eSpark-Backup/stephen-auto-p-w-rswitcher/Design-Files/Power-Switcher-v1.0/Deliverables/_Renderings/2D_TOP_View.png

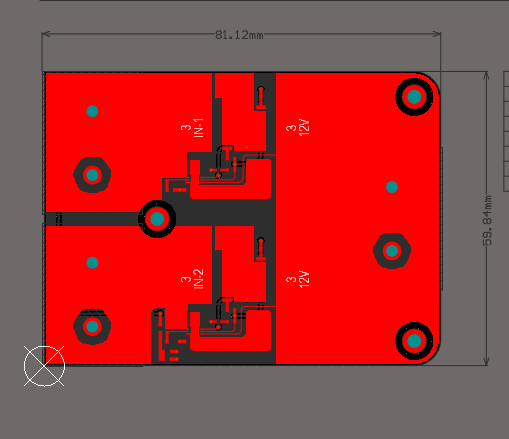
Design-Files/Power-Switcher-v1.0/Deliverables/_Renderings/2D_TOP_View.png
