eSpark-Backup/stephen-auto-p-w-rswitcher/Design-Files/Power-Switcher-v1.0/Deliverables/_Renderings/3D_Bottom_View.png

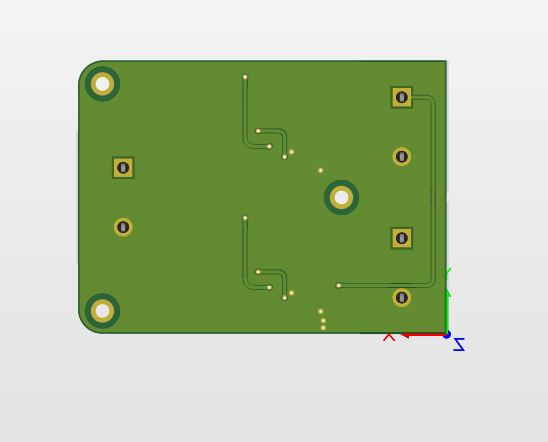
Design-Files/Power-Switcher-v1.0/Deliverables/_Renderings/3D_Bottom_View.png
