eSpark-Backup/stephen-auto-p-w-rswitcher/Design-Files/Power-Switcher-v1.0/Deliverables/BOM/Power-Switcher-v1.0.xlsx

# | Item Type | Designator | Description | Footprint | Manufacturer Part Number | Manufacturer | Value | Quantity | Remarks
1 | Capacitors | C1, C3 | CAP CER 10000PF 100V X7R 0402 | Cap-0402 | CC0402KRX7R0BB103 | Yageo | 10nF | 2
2 | Capacitor | C2, C4 | CAP CER 0.047UF 100V X7R 1206 | Cap-1206 | CC1206JRX7R0BB473 | Yageo | 0.047uF | 2
3 | Diodes | D1, D4 | DIODE ZENER 12V 200MW SOD323 | SOD-323 | MMSZ5242BS-7-F | Diodes | - | 2
4 | TVS Diodes | D2, D5 | TVS DIODE 24VWM 38.9VC DO214AC | SMA Bi Directional | SMAJ24CA | Littelfuse | - | 2
5 | Diodes | D3, D6 | DIODE STANDARD 100V 1A SMA | SMA(DO-214AC) | S1B-13-F | Diodes | - | 2
6 | Terminal Block | J1, J2, J3 | 1x2P Midfoot Barrier Block 2 1 13mm 40A -40℃~+105℃ 750V Black 10~18 Straight pin 6 Plugin,P=13mm Barrier Terminal Blocks ROHS | KF78C-13.0-2P | KF78C-13.0-2P | CiXi KaiFeng Electronics | - | 3
7 | MOSFET | Q1, Q2, Q3, Q5 | MOSFET N-CH 100V 49A/380A TOLLA | Tolla | AOTL66912 | Alpha & Omega Semiconductor | - | 4
8 | BJTs | Q4 | TRANS NPN 80V 0.5A SOT23-3 | SOT-23 | MMBTA06-7-F | Diodes | - | 1
9 | Resistor | R2, R11 | RES SMD 10 OHM 1% 1/10W 0603 | Res-0603 | RC0603FR-0710RL | Yageo | 10R | 2
10 | Resistor | R3, R5, R8, R9, R12 | RES SMD 10K Ohm 1% 1/10W 0603 | Res-0603 | RC0603FR-0710KL | Yageo | 10K | 5
11 | Resistor | R4, R6, R13 | RES SMD 1K OHM 1% 1/10W 0603 | Res-0603 | RC0603FR-071KL | Yageo | 1K | 3
12 | Resistors | R10 | RES 100K OHM 1% 1/10W 0603 | Res-0603 | RC0603FR-07100KL | Yageo | 100K | 1
13 | IC | U1, U2 | IC OR CTRLR N+1 6DFN | DFN-6-EP(2x3) | LTC4359HDCB#TRPBF | Analog Devices / Linear Technology | - | 2
14 | Peripherals | HeatSink | 31.3*18.5*45MM 6063-T5 Heat sink / cooling fin ROHS | Custom | XSD183-097-B | XSD | - | 1
