eSpark-Backup/stephen-auto-p-w-rswitcher/Design-Files/Power-Switcher-v1.0/Deliverables/_Supporting Files/Power-Switcher-v1.0.step

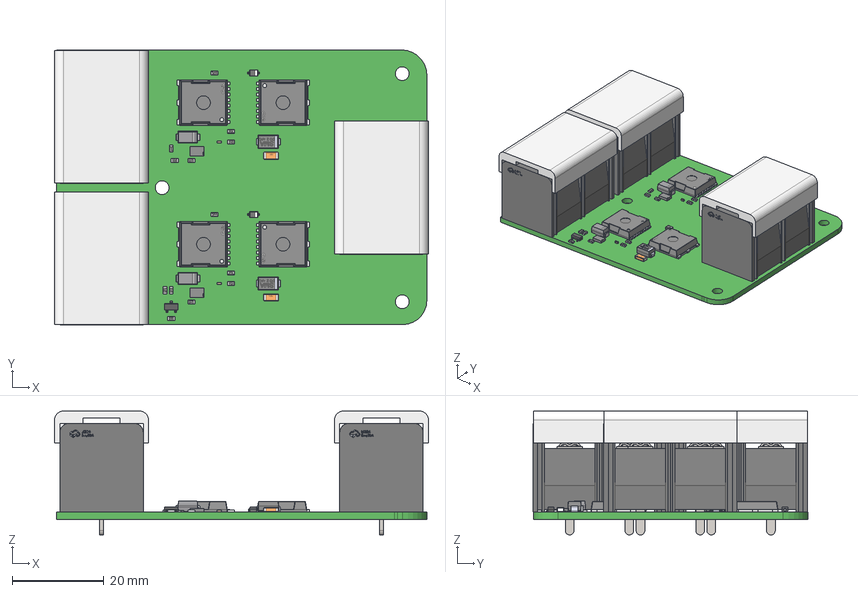
[picture p7: CAD file, 2025-07-15]
Design-Files/Power-Switcher-v1.0/Deliverables/_Supporting Files/Power-Switcher-v1.0.step
81.5 x 59.9 x 27.0 mm
User Library-RESC1608X05N x 13
CircuitWorks-SOT-23
SMA (DO-214AC) x 2
User Library-DO-214AC SMA x 2
User Library-SOD323-1 x 2
User Library-1206 SMD Capacitor x 2
User Library-Capacitor 0402 x 2
