eSpark-Backup/stephen-auto-p-w-rswitcher/(list of files, cad)

Other CAD files:
Design-Files/Power-Switcher-v1.0/Deliverables/_Supporting Files/Power-Switcher-v1.0..DWG
Design-Files/Power-Switcher-v1.0/Deliverables/_Supporting Files/Power-Switcher-v1.0.DXF
