eSpark-Backup/stephen-auto-p-w-rswitcher/Design-Files/Power-Switcher-v1.0/Schematic/Power-Switcher-v1.0.pdf

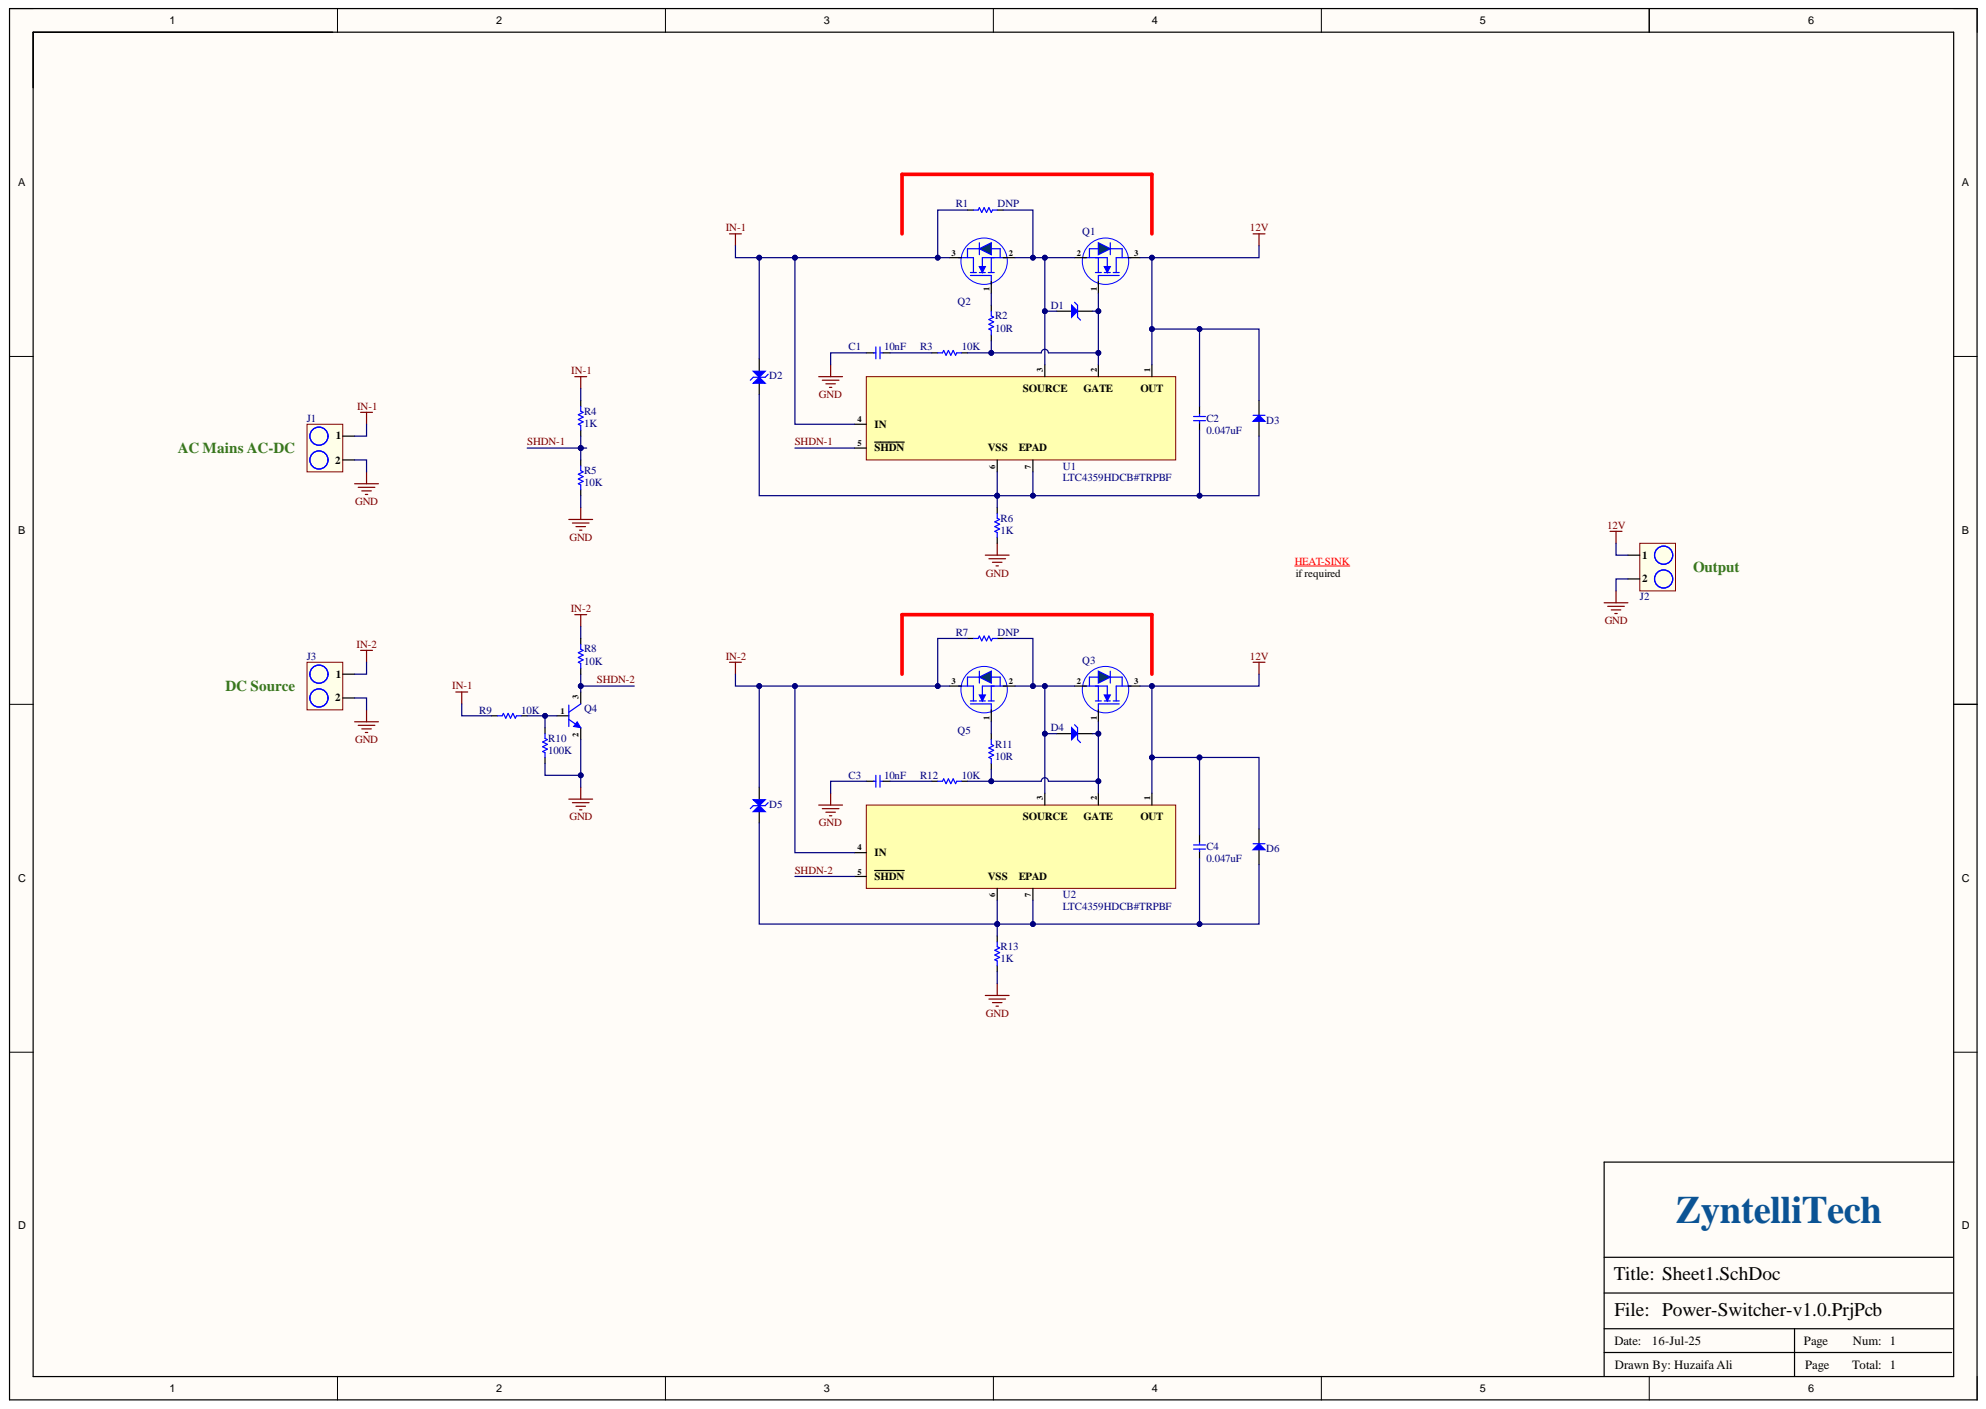
[picture p8: page 1]

Date : 1 6-Jul-2 5 | P a g e Nu m : 11

Drawn By: Hu z aifa Ali | P a g e T ota l :
