eSpark-Backup/stephen-auto-p-w-rswitcher/Design-Files/Power-Switcher-v1.0/Deliverables/_Schematics/Assembly File.pdf

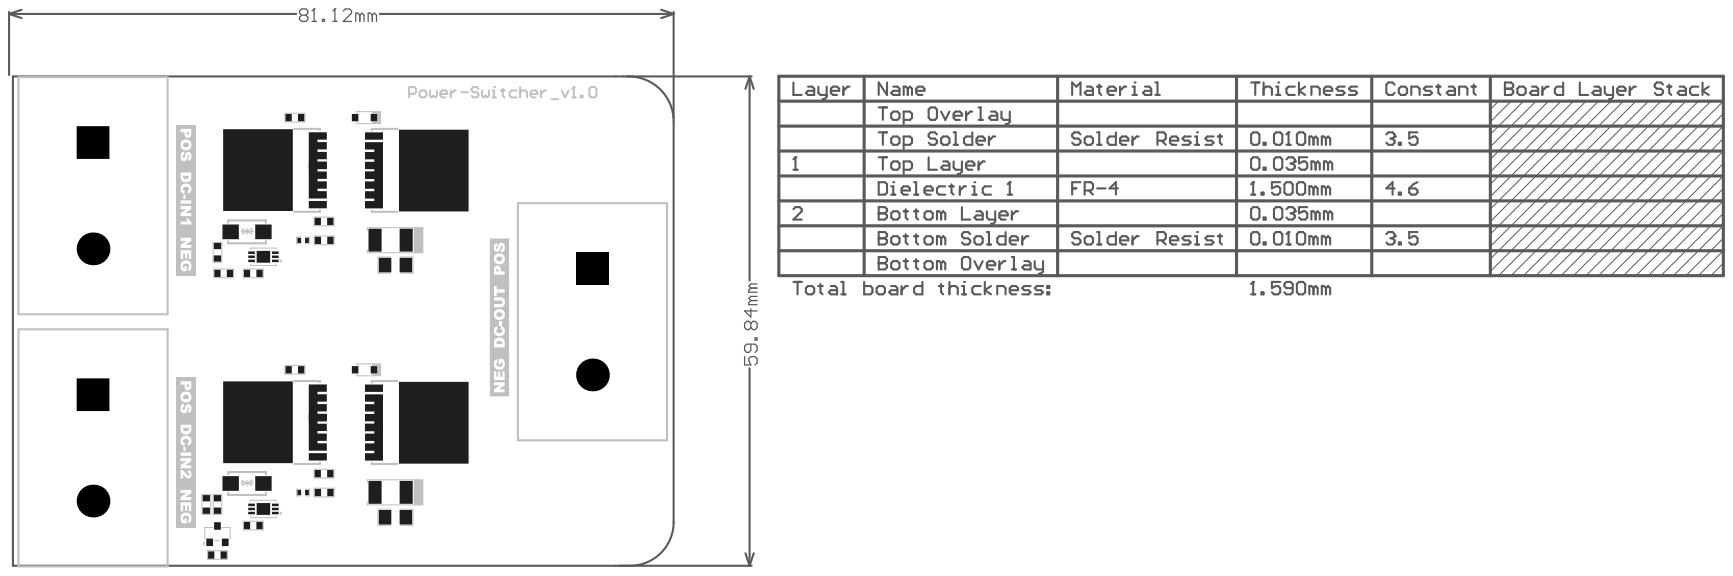
[picture p9: page 1]

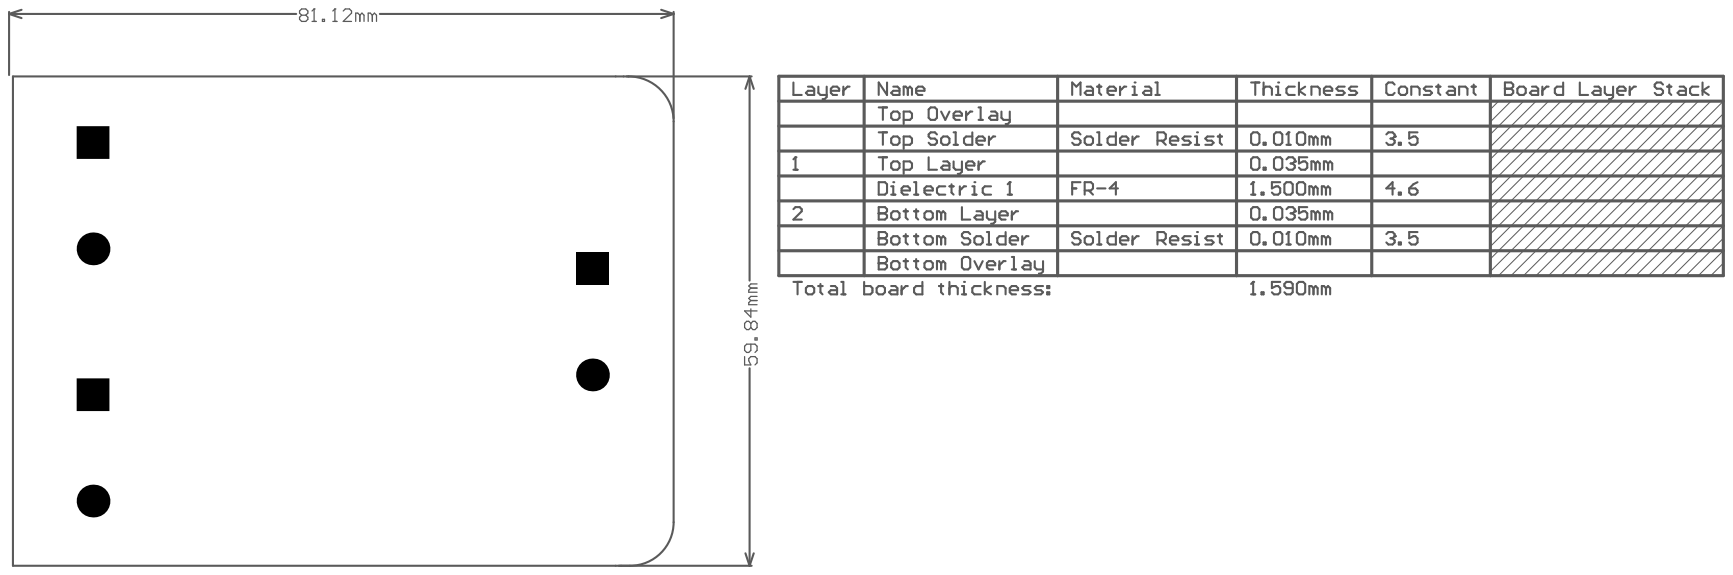
[picture p10: page 2]
