eSpark-Backup/stephen-auto-p-w-rswitcher/(list of files, drawings)

Other design files:
Design-Files/Power-Switcher-v1.0/Power-Switcher-v1.0.PcbDoc
Design-Files/Power-Switcher-v1.0/Power-Switcher-v1.0.PrjPcb
Design-Files/Power-Switcher-v1.0/Sheet1.SchDoc
