eSpark-Backup/stephen-auto-p-w-rswitcher/(commit log)

2025-07-15 #1 SCH design Completed
    [Power-Switcher-v1.0.PrjPcb, Sheet1.SchDoc]
2025-07-15 #2 PCB Completed and Deliverables generated
    [Centroid File.csv, Pick Place for Power-Switcher-v1.0.csv, Power-Switcher-v1.0..DWG, Power-Switcher-v1.0.DXF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]
2025-07-15 Client BOM added With heat sink peripheral
    [Power-Switcher-v1.0.xlsx]
2025-07-16 #1 #2 Heat sink updated in schematic and BOM file. PDF updated.
    [Power-Switcher-v1.0.xlsx, Sheet1.SchDoc]
